controlXic/Pocket_CAN/02_CAD/01_STL/canTool.png

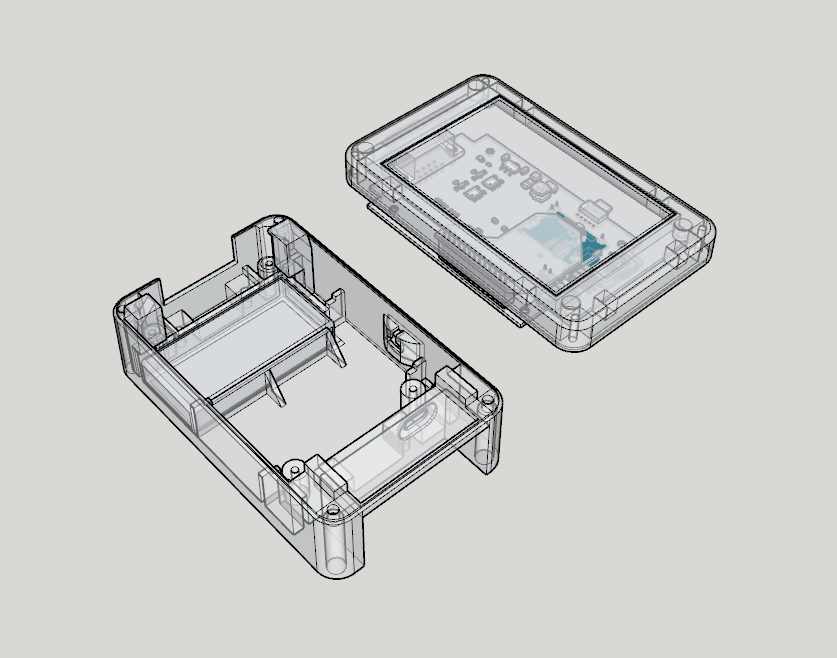
02_CAD/01_STL/canTool.png
