controlXic/Pocket_CAN/02_CAD/01_STL/_tapa.stl

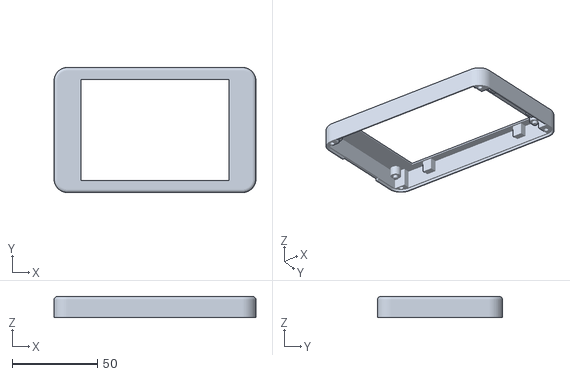
[picture p4: CAD file, 2026-11-03]
02_CAD/01_STL/_tapa.stl
118.2 x 73.3 x 12.3
