controlXic/Pocket_CAN/02_CAD/01_STL/soportsDysplay2.stl

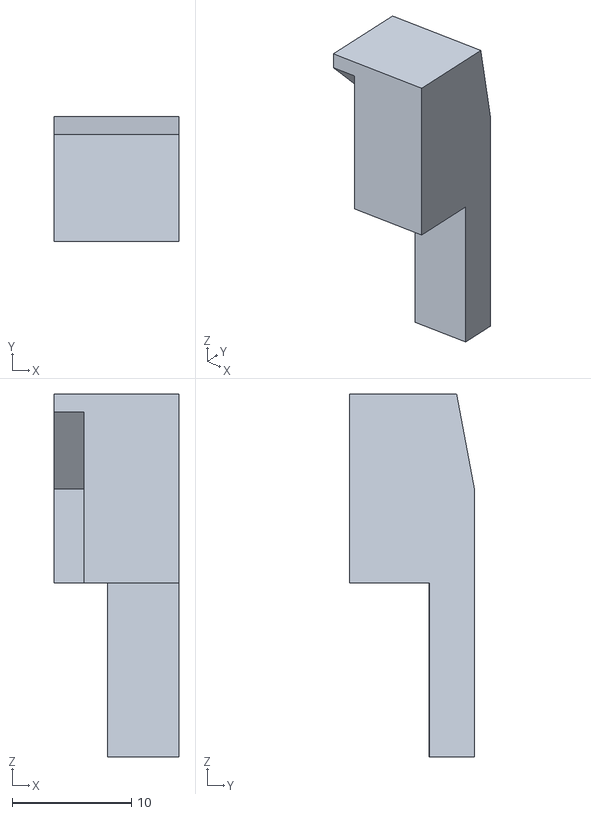
[picture p5: CAD file, 2026-11-03]
02_CAD/01_STL/soportsDysplay2.stl
10.5 x 10.5 x 30.5
