controlXic/Pocket_CAN/02_CAD/01_STL/_base.stl

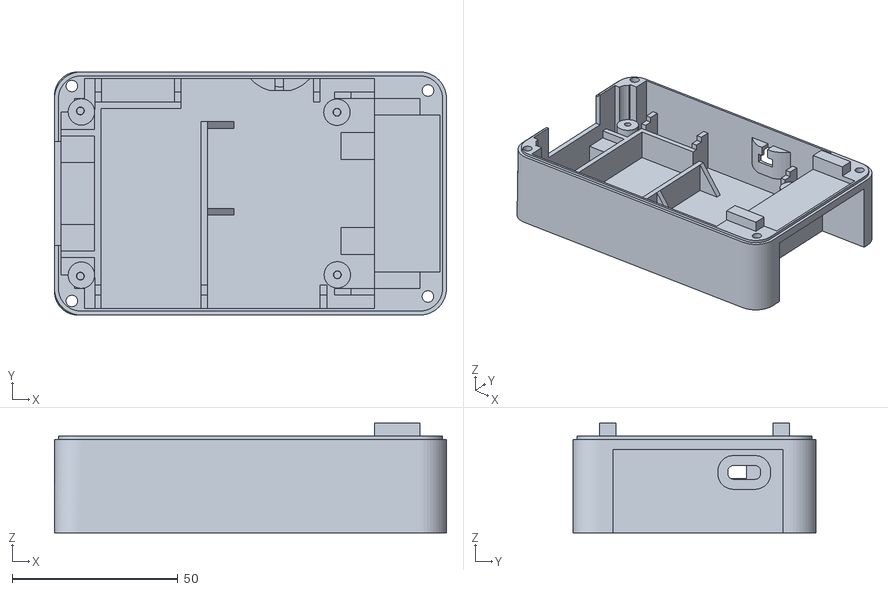
[picture p6: CAD file, 2026-11-03]
02_CAD/01_STL/_base.stl
118.2 x 73.3 x 33.1
