controlXic/Pocket_CAN/02_CAD/01_STL/base_proto_CAN_tool.stl

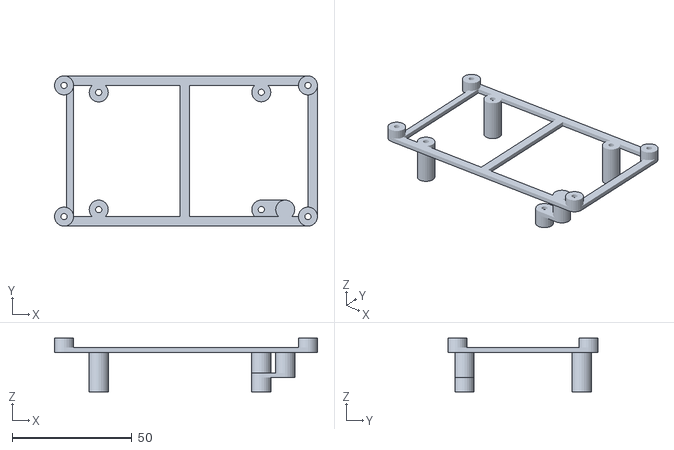
[picture p7: CAD file, 2026-11-03]
02_CAD/01_STL/base_proto_CAN_tool.stl
110.0 x 62.9 x 22.5
