controlXic/Pocket_CAN/02_CAD/01_STL/soportsDysplay.stl

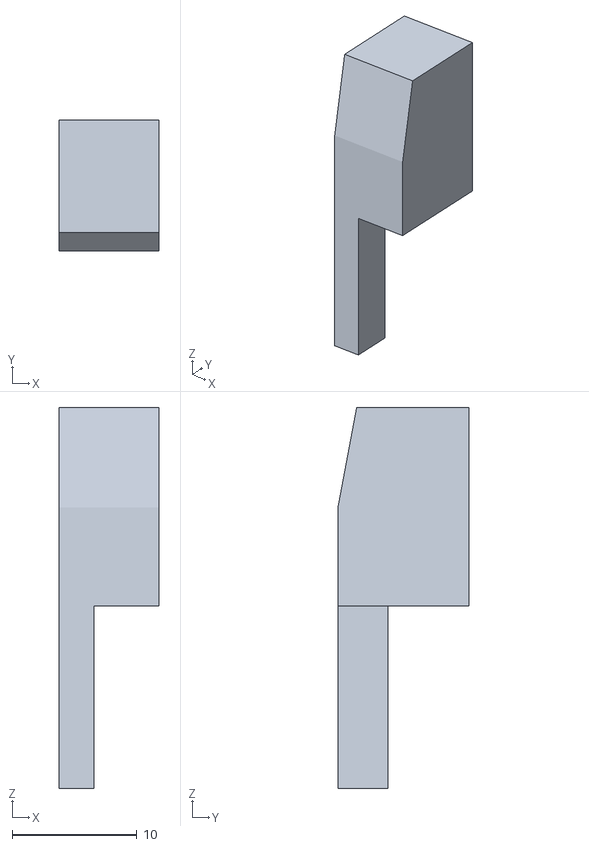
[picture p8: CAD file, 2026-11-03]
02_CAD/01_STL/soportsDysplay.stl
8.00 x 10.5 x 30.5
