controlXic/Pocket_CAN/02_CAD/01_STL/gruix_CAN_tool.stl

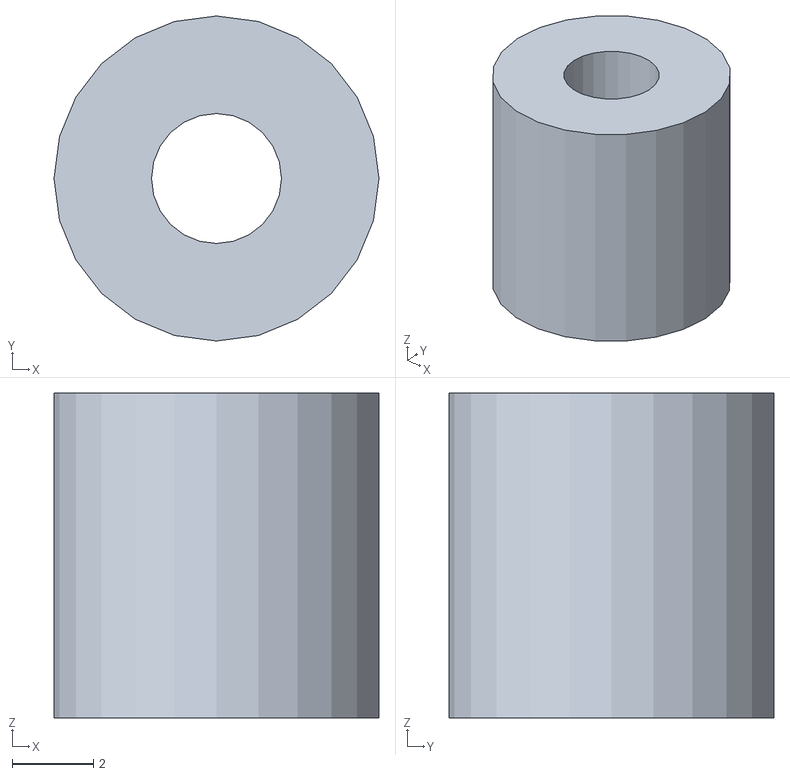
[picture p9: CAD file, 2026-11-03]
02_CAD/01_STL/gruix_CAN_tool.stl
8.00 x 8.00 x 8.00
