controlXic/Pocket_CAN/(list of files, cad)

Other CAD files:
02_CAD/00_WORK/CAN_tool.skp
