controlXic/Pocket_CAN/01_PCB/PCB_STM32G474/PCB_STM32G474.kicad_pcb

## KiCad design 01_PCB/PCB_STM32G474/PCB_STM32G474.kicad_pcb (2026-11-03)

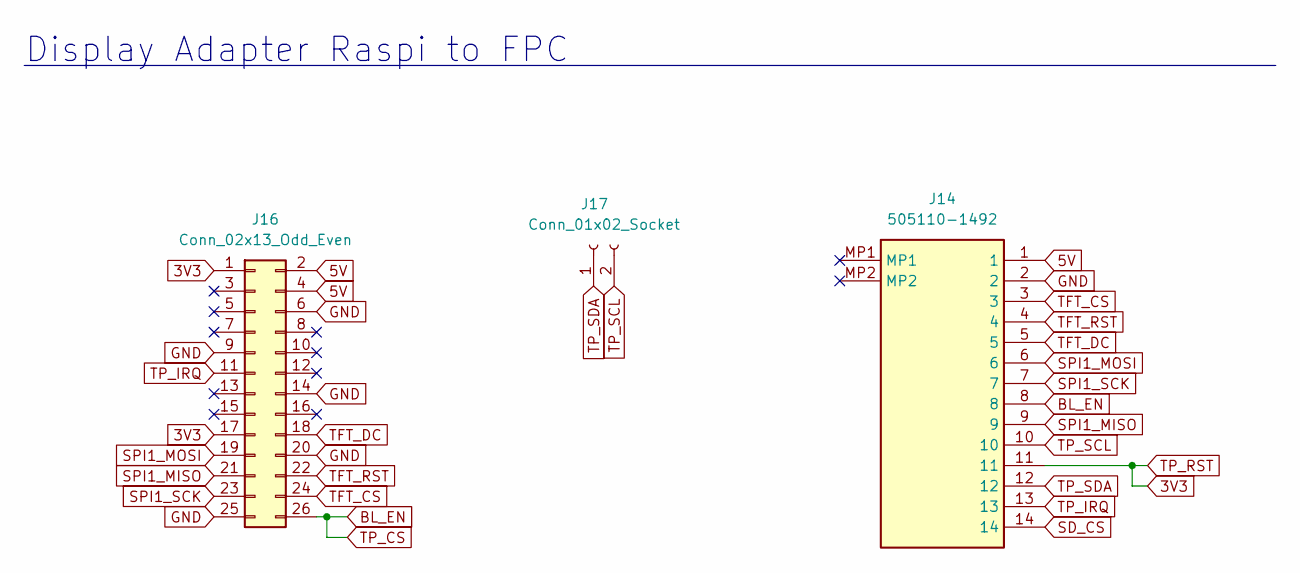
[picture p10: schematic displayadapter.kicad_sch]

Parts:
J14: 505110-1492; 5051101492; Manufacturer_Part_Number 505110-1492; Mouser Part Number 538-505110-1492
J16: Conn_02x13_Odd_Even; PinSocket_2x13_P2.54mm_Vertical
J17: Conn_01x02_Socket; PinSocket_1x02_P2.54mm_Vertical

Connections:
3V3: J14.11, J16.1, J16.17; also elsewhere on the board
5V: J14.1, J16.2, J16.4; also elsewhere on the board
BL_EN: J14.8, J16.26; also elsewhere on the board
GND: J14.2, J16.6, J16.9, J16.14, J16.20, J16.25; also elsewhere on the board
IO1: J14.12, J17.1; also elsewhere on the board
IO2: J14.10, J17.2; also elsewhere on the board
SD_CS: J14.14; also elsewhere on the board
SPI1_MISO: J14.9, J16.21; also elsewhere on the board
SPI1_MOSI: J14.6, J16.19; also elsewhere on the board
SPI1_SCK: J14.7, J16.23; also elsewhere on the board
TFT_CS: J14.3, J16.24; also elsewhere on the board
TFT_DC: J14.5, J16.18; also elsewhere on the board
TFT_RST: J14.4, J16.22; also elsewhere on the board
TP_IRQ: J14.13, J16.11; also elsewhere on the board

Notes on the sheet:
Display Adapter Raspi to FPC

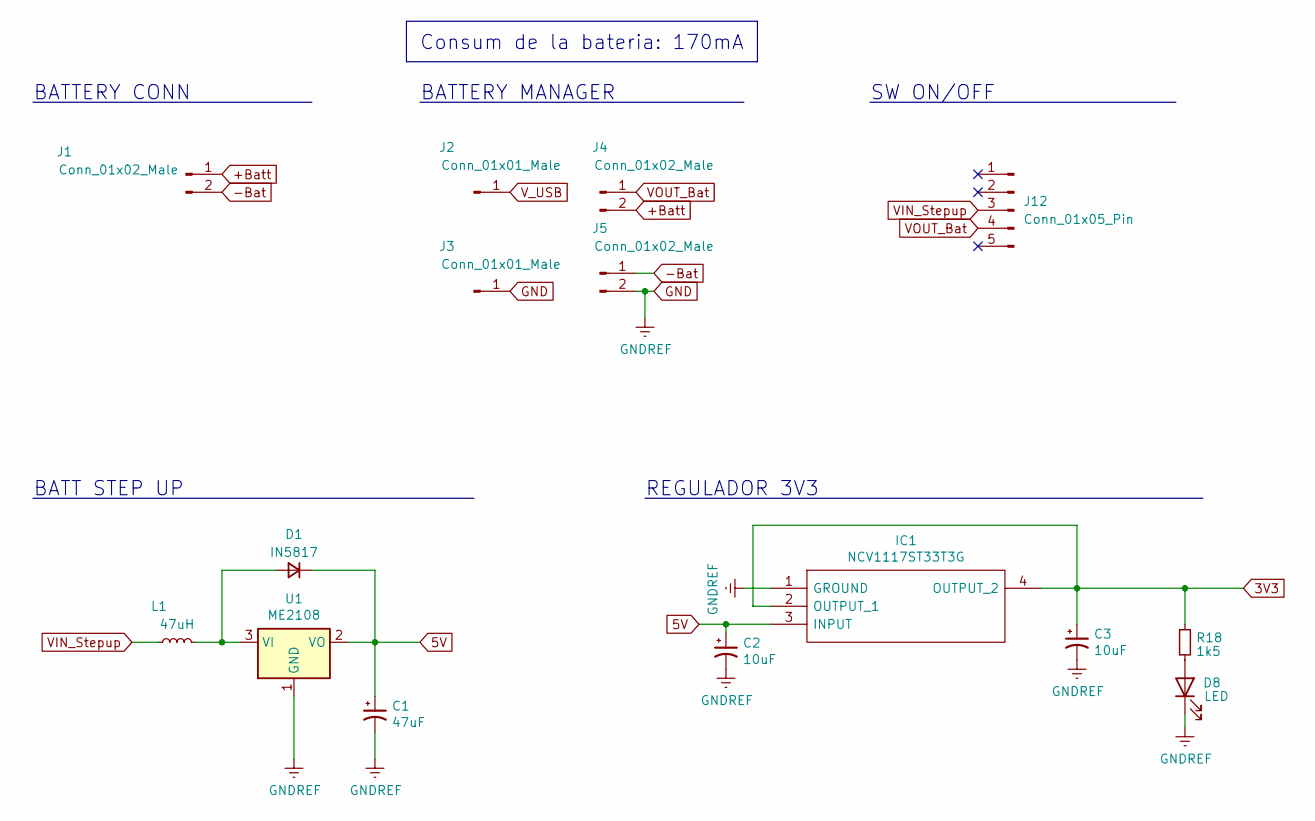
[picture p11: schematic pwr.kicad_sch]

Parts:
C1: 47uF; CP_EIA-3528-21_Kemet-B_Pad1.50x2.35mm_HandSolder
C2, C3: 10uF; CP_EIA-3216-18_Kemet-A
D1: IN5817; D_SMA
D8: LED; LED_1206_3216Metric
IC1: NCV1117ST33T3G; SOT-223-3_TabPin2; Manufacturer_Part_Number NCV1117ST33T3G; Mouser Part Number 863-NCV1117ST33T3G
J1: Conn_01x02_Male; PinHeader_1x02_P2.54mm_Horizontal
J2, J3: Conn_01x01_Male; PinSocket_1x01_P2.54mm_Vertical
J4, J5: Conn_01x02_Male; PinSocket_1x02_P2.54mm_Vertical
J12: Conn_01x05_Pin; PinHeader_1x05_P2.00mm_Vertical
L1: 47uH; L_Bourns_SRN6045TA
R18: 1k5; R_0805_2012Metric
U1: ME2108; SOT-89-3

Connections:
3V3: C3.1, IC1.2 (OUTPUT_1), IC1.4 (OUTPUT_2), R18.1; also elsewhere on the board
5V: C1.1, C2.1, D1.1 (K), IC1.3 (INPUT), U1.2 (VO); also elsewhere on the board
+Batt: J1.1, J4.2; also elsewhere on the board
-Bat: J1.2, J5.1
GND: C1.2, C2.2, C3.2, D8.1 (K), IC1.1 (GROUND), J3.1, J5.2, U1.1 (GND); also elsewhere on the board
unnamed: D1.2 (A), L1.2, U1.3 (VI)
unnamed: D8.2 (A), R18.2
VIN_Stepup: J12.3, L1.1
VOUT_Bat: J4.1, J12.4
V_USB: J2.1; also elsewhere on the board

Notes on the sheet:
Consum de la bateria: 170mA
REGULADOR 3V3
BATTERY CONN
BATTERY MANAGER
BATT STEP UP
SW ON/OFF

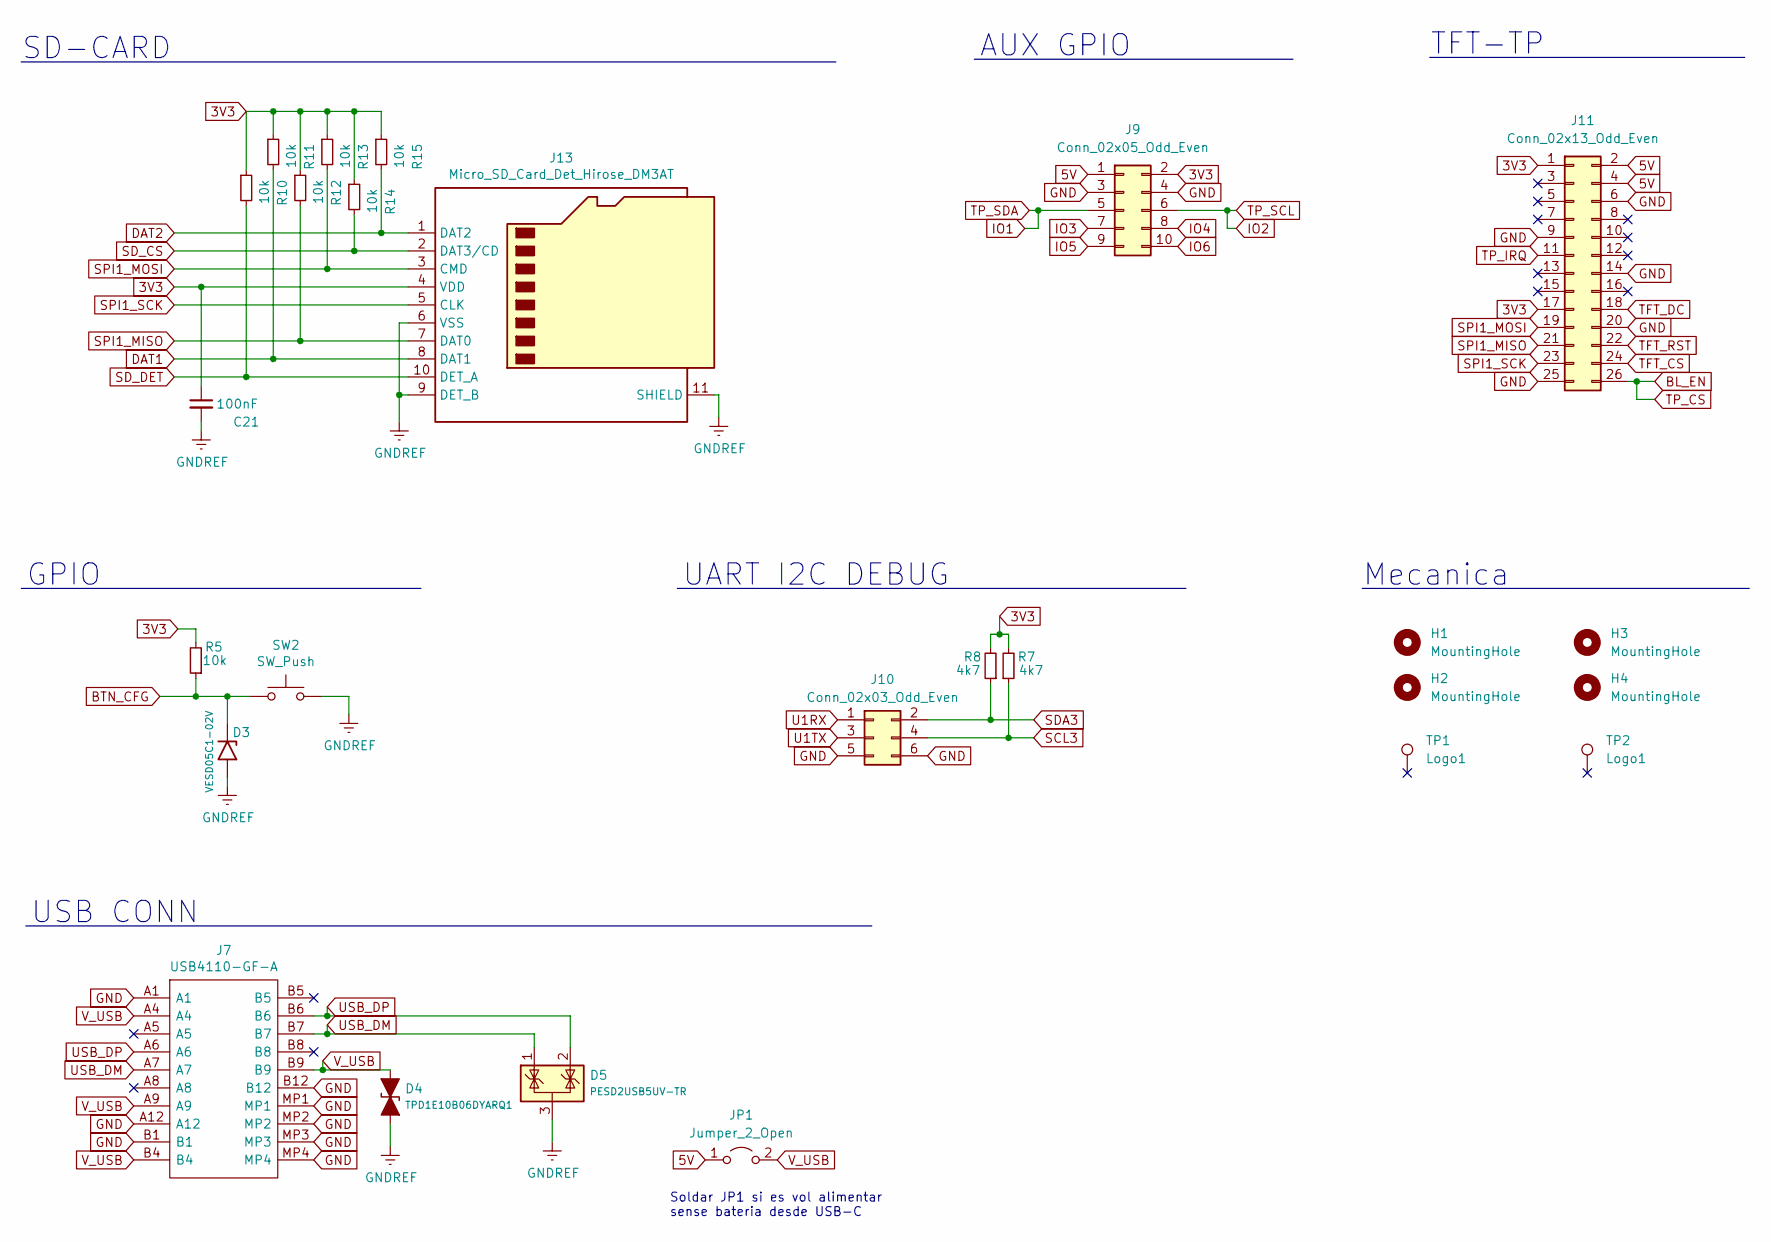
[picture p12: schematic periferics.kicad_sch]

Parts:
C21: 100nF; C_0603_1608Metric
D3: VESD05C1-02V; D_SOD-523
D4: TPD1E10B06DYARQ1; D_SOD-523
D5: PESD2USB5UV-TR; SOT-23
H1, H2, H3, H4: MountingHole; MountingHole_3.2mm_M3
J7: USB4110-GF-A; USB4110GFA; Manufacturer_Part_Number USB4110-GF-A; Mouser Part Number 640-USB4110-GF-A
J9: Conn_02x05_Odd_Even; PinHeader_2x05_P2.54mm_Horizontal
J10: Conn_02x03_Odd_Even; PinHeader_2x03_P2.54mm_Horizontal
J11: Conn_02x13_Odd_Even; PinHeader_2x13_P2.54mm_Vertical
J13: Micro_SD_Card_Det_Hirose_DM3AT; microSD_HC_Hirose_DM3AT-SF-PEJM5
JP1: Jumper_2_Open; SolderJumper-2_P1.3mm_Open_TrianglePad1.0x1.5mm
R5, R10, R11, R12, R13, R14, R15: 10k; R_0603_1608Metric
R7, R8: 4k7; R_0603_1608Metric
SW2: SW_Push; SW_SPST_CK_RS282G05A3
TP1, TP2: Logo1; cxic

Connections:
3V3: C21.1, J9.2, J11.1, J11.17, J13.4 (VDD), R5.2, R7.2, R8.2, R10.1, R11.1, R12.1, R13.1, R14.1, R15.1; also elsewhere on the board
5V: J9.1, J11.2, J11.4, JP1.1 (A); also elsewhere on the board
BL_EN: J11.26; also elsewhere on the board
BTN_CFG: D3.1 (A1), R5.1, SW2.1; also elsewhere on the board
DAT1: J13.8 (DAT1), R11.2
DAT2: J13.1 (DAT2), R15.2
GND: C21.2, D3.2 (A2), D4.2 (A2), D5.3 (A), J7.A1, J7.A12, J7.B1, J7.B12, J7.MP1, J7.MP2, J7.MP3, J7.MP4, J9.3, J9.4, J10.5, J10.6, J11.6, J11.9, J11.14, J11.20, J11.25, J13.6 (VSS), J13.9 (DET_B), J13.11 (SHIELD), SW2.2; also elsewhere on the board
IO1: J9.5; also elsewhere on the board
IO2: J9.6; also elsewhere on the board
IO3: J9.7; also elsewhere on the board
IO4: J9.8; also elsewhere on the board
IO5: J9.9; also elsewhere on the board
IO6: J9.10; also elsewhere on the board
SCL3: J10.4, R7.1; also elsewhere on the board
SDA3: J10.2, R8.1; also elsewhere on the board
SD_CS: J13.2 (DAT3/CD), R14.2; also elsewhere on the board
SD_DET: J13.10 (DET_A), R10.2; also elsewhere on the board
SPI1_MISO: J11.21, J13.7 (DAT0), R12.2; also elsewhere on the board
SPI1_MOSI: J11.19, J13.3 (CMD), R13.2; also elsewhere on the board
SPI1_SCK: J11.23, J13.5 (CLK); also elsewhere on the board
TFT_CS: J11.24; also elsewhere on the board
TFT_DC: J11.18; also elsewhere on the board
TFT_RST: J11.22; also elsewhere on the board
TP_IRQ: J11.11; also elsewhere on the board
U1RX: J10.1; also elsewhere on the board
U1TX: J10.3; also elsewhere on the board
USB_DM: D5.1 (K), J7.A7, J7.B7; also elsewhere on the board
USB_DP: D5.2 (K), J7.A6, J7.B6; also elsewhere on the board
V_USB: D4.1 (A1), J7.A4, J7.A9, J7.B4, J7.B9, JP1.2 (B); also elsewhere on the board

Notes on the sheet:
Soldar JP1 si es vol alimentar sense bateria desde USB-C
SD-CARD
UART I2C DEBUG
TFT-TP
AUX GPIO
USB CONN
Mecanica
GPIO

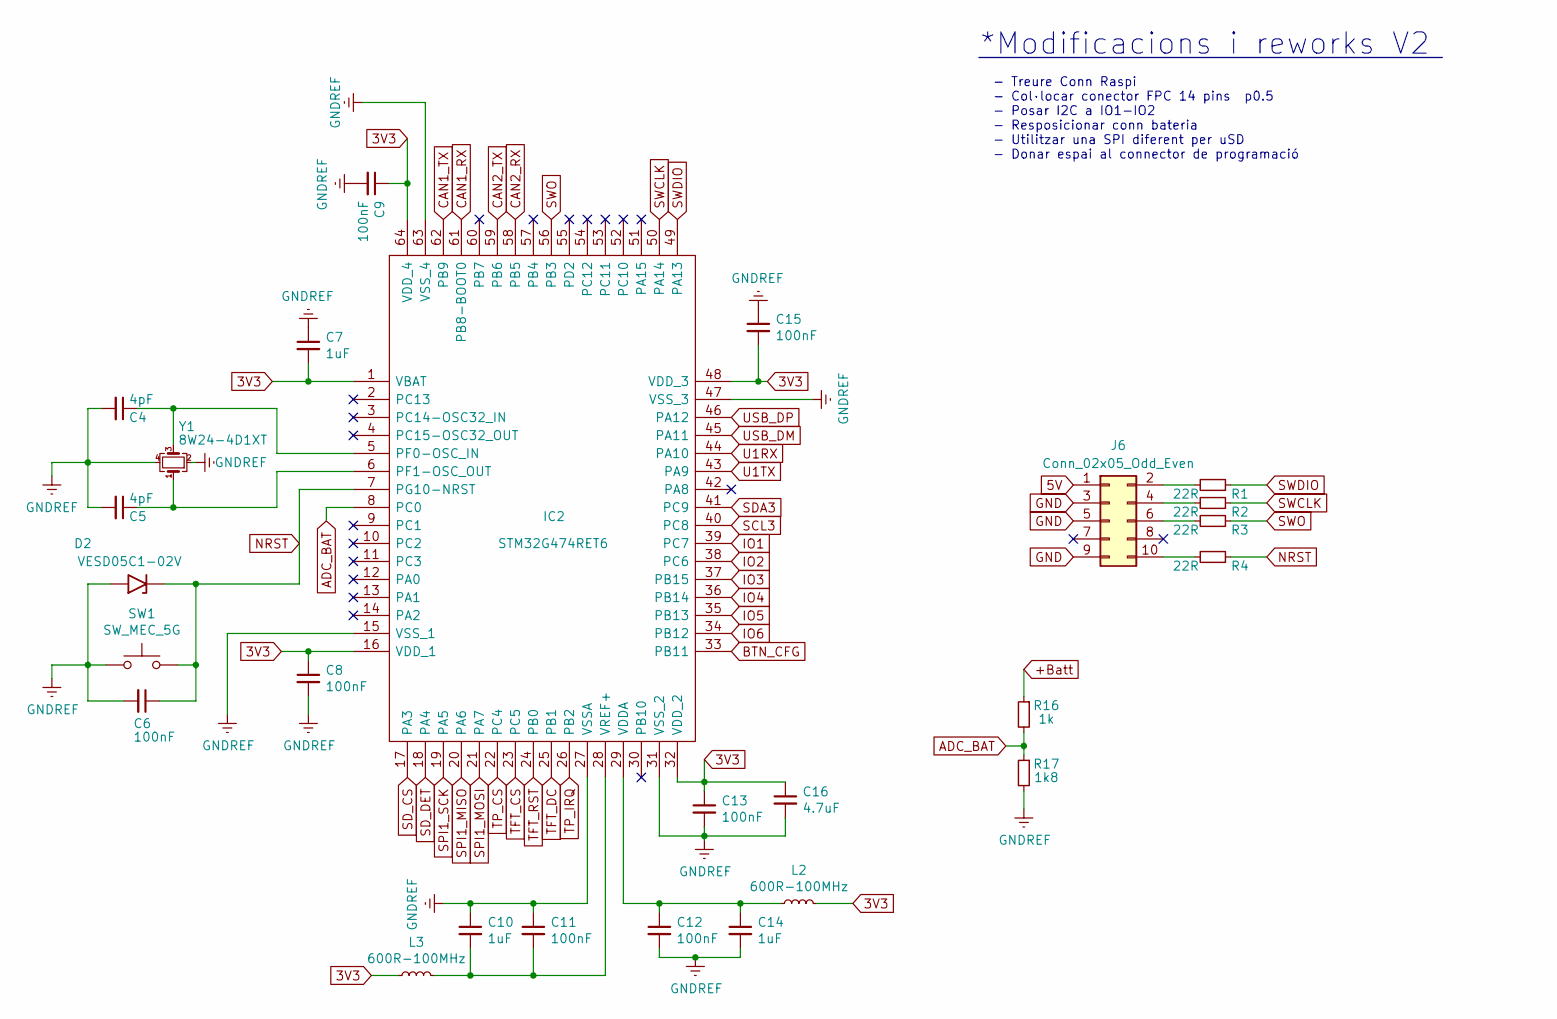
[picture p13: schematic mcu.kicad_sch]

Parts:
C4, C5: 4pF; C_0805_2012Metric
C6, C8, C9, C11, C12, C13, C15: 100nF; C_0603_1608Metric
C7, C10, C14: 1uF; C_0805_2012Metric
C16: 4.7uF; C_0805_2012Metric
D2: VESD05C1-02V; D_SOD-523
IC2: STM32G474RET6; QFP50P1200X1200X160-64N; Manufacturer_Part_Number STM32G474RET6; Mouser Part Number 511-STM32G474RET6
J6: Conn_02x05_Odd_Even; PinHeader_2x05_P1.27mm_Vertical
L2, L3: 600R-100MHz; C_0805_2012Metric
R1, R2, R3, R4: 22R; R_0603_1608Metric
R16: 1k; R_0603_1608Metric
R17: 1k8; R_0603_1608Metric
SW1: SW_MEC_5G; 223JMVAAR
Y1: 8W24-4D1XT; ABM8W480000MHZ6D1XT3

Connections:
3V3: C7.2, C8.1, C9.1, C13.1, C15.2, C16.1, IC2.1 (VBAT), IC2.16 (VDD_1), IC2.32 (VDD_2), IC2.48 (VDD_3), IC2.64 (VDD_4), L2.2, L3.1; also elsewhere on the board
5V: J6.1; also elsewhere on the board
+Batt: R16.1; also elsewhere on the board
ADC_BAT: IC2.8 (PC0), R16.2, R17.1
BL_EN: IC2.22 (PC4); also elsewhere on the board
BTN_CFG: IC2.33 (PB11); also elsewhere on the board
CAN1_RX: IC2.61 (PB8-BOOT0); also elsewhere on the board
CAN1_TX: IC2.62 (PB9); also elsewhere on the board
CAN2_RX: IC2.58 (PB5); also elsewhere on the board
CAN2_TX: IC2.59 (PB6); also elsewhere on the board
GND: C4.2, C5.2, C6.2, C7.1, C8.2, C9.2, C10.1, C11.1, C12.2, C13.2, C14.2, C15.1, C16.2, D2.2 (A2), IC2.15 (VSS_1), IC2.27 (VSSA), IC2.31 (VSS_2), IC2.47 (VSS_3), IC2.63 (VSS_4), J6.3, J6.5, J6.9, R17.2, SW1.2, Y1.2, Y1.4; also elsewhere on the board
IO1: IC2.39 (PC7); also elsewhere on the board
IO2: IC2.38 (PC6); also elsewhere on the board
IO3: IC2.37 (PB15); also elsewhere on the board
IO4: IC2.36 (PB14); also elsewhere on the board
IO5: IC2.35 (PB13); also elsewhere on the board
IO6: IC2.34 (PB12); also elsewhere on the board
NRST: C6.1, D2.1 (A1), IC2.7 (PG10-NRST), R4.1, SW1.1
unnamed: C4.1, IC2.5 (PF0-OSC_IN), Y1.3
unnamed: C5.1, IC2.6 (PF1-OSC_OUT), Y1.1
unnamed: C12.1, C14.1, IC2.29 (VDDA), L2.1
unnamed: C10.2, C11.2, IC2.28 (VREF+), L3.2
unnamed: J6.2, R1.2
unnamed: J6.4, R2.2
unnamed: J6.6, R3.2
unnamed: J6.10, R4.2
SCL3: IC2.40 (PC8); also elsewhere on the board
SDA3: IC2.41 (PC9); also elsewhere on the board
SD_CS: IC2.17 (PA3); also elsewhere on the board
SD_DET: IC2.18 (PA4); also elsewhere on the board
SPI1_MISO: IC2.20 (PA6); also elsewhere on the board
SPI1_MOSI: IC2.21 (PA7); also elsewhere on the board
SPI1_SCK: IC2.19 (PA5); also elsewhere on the board
SWCLK: IC2.50 (PA14), R2.1
SWDIO: IC2.49 (PA13), R1.1
SWO: IC2.56 (PB3), R3.1
TFT_CS: IC2.23 (PC5); also elsewhere on the board
TFT_DC: IC2.25 (PB1); also elsewhere on the board
TFT_RST: IC2.24 (PB0); also elsewhere on the board
TP_IRQ: IC2.26 (PB2); also elsewhere on the board
U1RX: IC2.44 (PA10); also elsewhere on the board
U1TX: IC2.43 (PA9); also elsewhere on the board
USB_DM: IC2.45 (PA11); also elsewhere on the board
USB_DP: IC2.46 (PA12); also elsewhere on the board

Notes on the sheet:
*Modificacions i reworks V2
- Treure Conn Raspi - Col·locar conector FPC 14 pins p0.5 - Posar I2C a IO1-IO2 - Resposicionar conn bateria - Utilitzar una SPI diferent per uSD - Donar espai al connector de programació

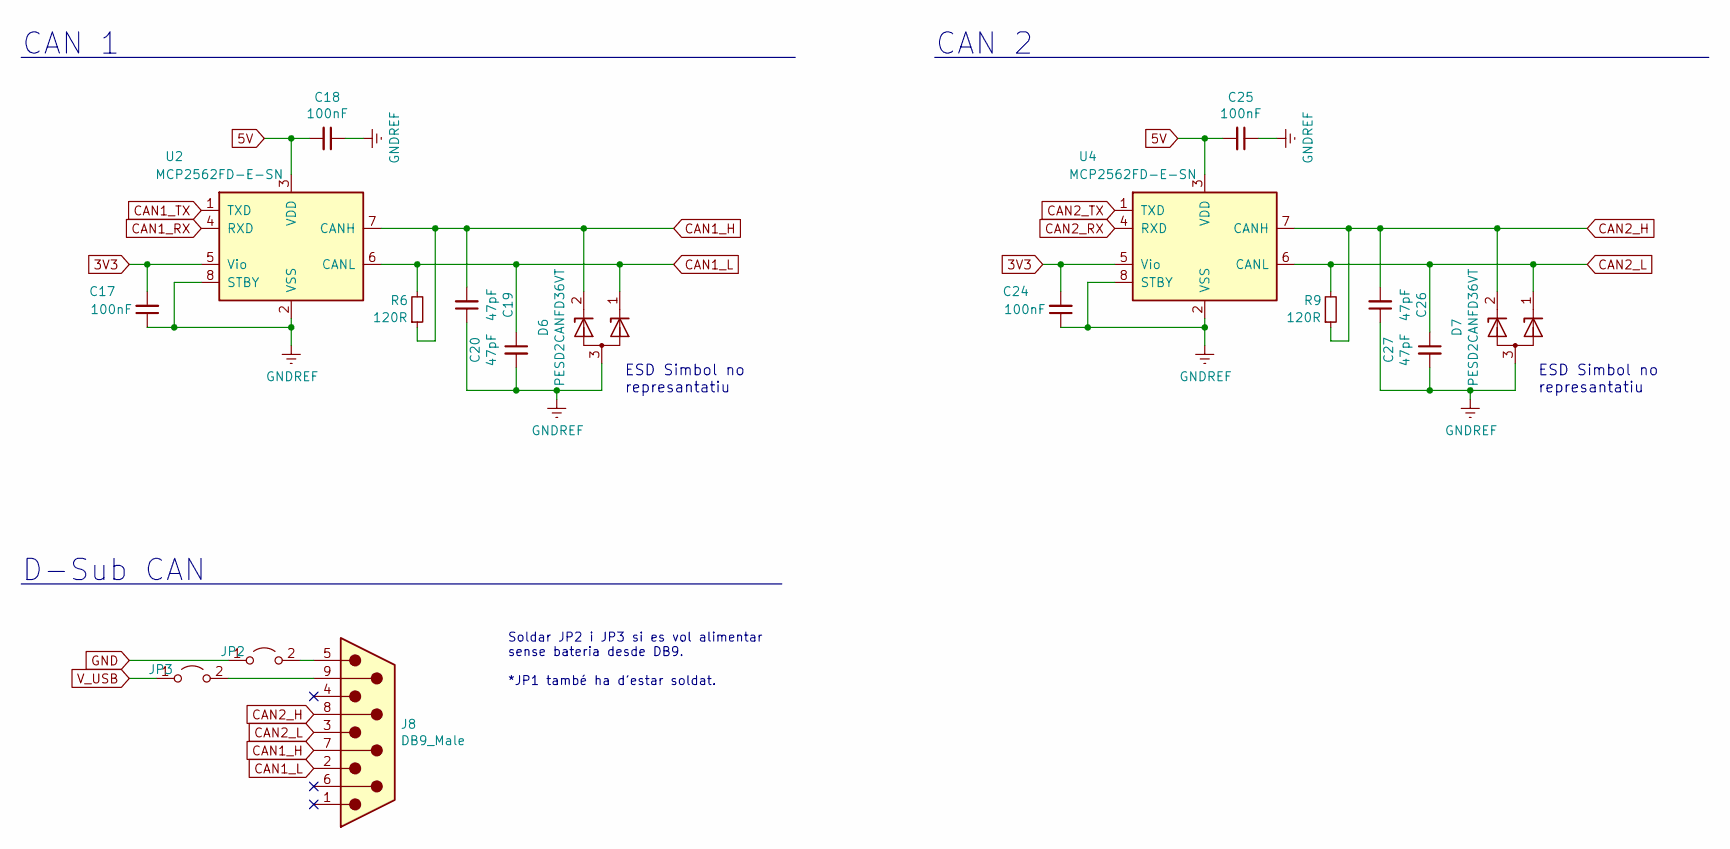
[picture p14: schematic can.kicad_sch]

Parts:
C17, C18, C24, C25: 100nF; C_0603_1608Metric
C19, C20, C26, C27: 47pF; C_0603_1608Metric
D6, D7: PESD2CANFD36VT; SOT-23
J8: DB9_Male; DSUB-9_Male_Horizontal_P2.77x2.84mm_EdgePinOffset7.70mm_Hou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
JP2, JP3: Jumper_2_Open; SolderJumper-2_P1.3mm_Open_TrianglePad1.0x1.5mm
R6, R9: 120R; R_0805_2012Metric
U2, U4: MCP2562FD-E-SN; SOIC-8_3.9x4.9mm_P1.27mm

Connections:
3V3: C17.2, C24.2, U2.5 (Vio), U4.5 (Vio); also elsewhere on the board
5V: C18.2, C25.2, U2.3 (VDD), U4.3 (VDD); also elsewhere on the board
CAN1_H: C19.2, D6.2 (K), J8.7, R6.1, U2.7 (CANH)
CAN1_L: C20.1, D6.1 (K), J8.2, R6.2, U2.6 (CANL)
CAN1_RX: U2.4 (RXD); also elsewhere on the board
CAN1_TX: U2.1 (TXD); also elsewhere on the board
CAN2_H: C26.2, D7.2 (K), J8.8, R9.1, U4.7 (CANH)
CAN2_L: C27.1, D7.1 (K), J8.3, R9.2, U4.6 (CANL)
CAN2_RX: U4.4 (RXD); also elsewhere on the board
CAN2_TX: U4.1 (TXD); also elsewhere on the board
GND: C17.1, C18.1, C19.1, C20.2, C24.1, C25.1, C26.1, C27.2, D6.3 (A), D7.3 (A), JP2.1 (A), U2.2 (VSS), U2.8 (STBY), U4.2 (VSS), U4.8 (STBY); also elsewhere on the board
unnamed: J8.5, JP2.2 (B)
unnamed: J8.9, JP3.2 (B)
V_USB: JP3.1 (A); also elsewhere on the board

Notes on the sheet:
ESD Simbol no represantatiu
Soldar JP2 i JP3 si es vol alimentar sense bateria desde DB9. *JP1 també ha d'estar soldat.
CAN 1
D-Sub CAN
CAN 2

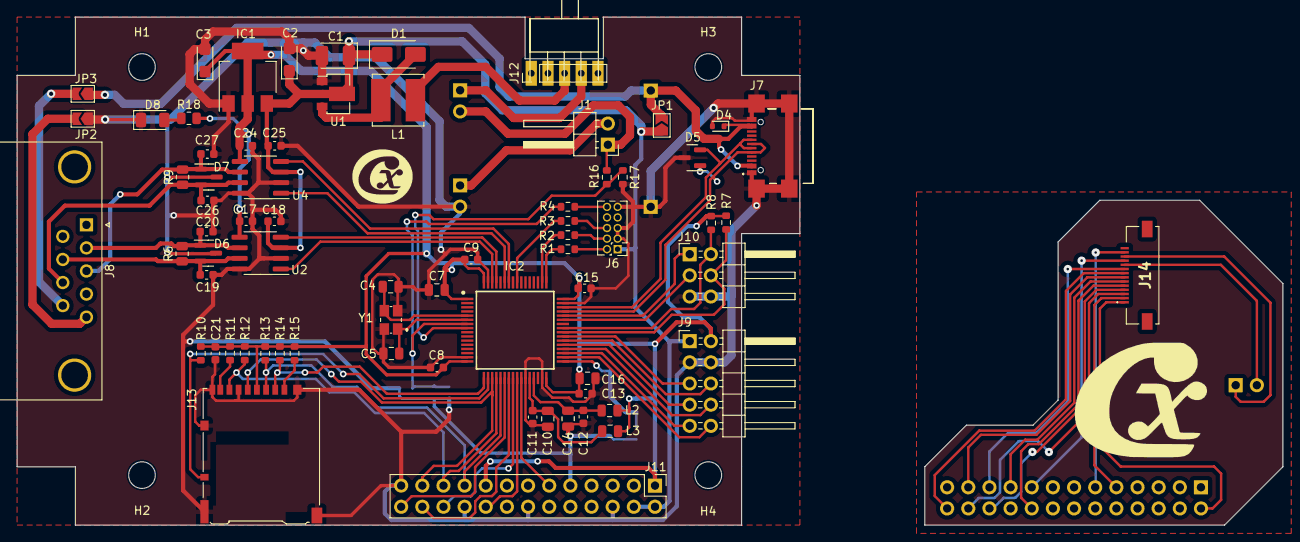
[picture p15: board PCB_STM32G474.kicad_pcb from above]

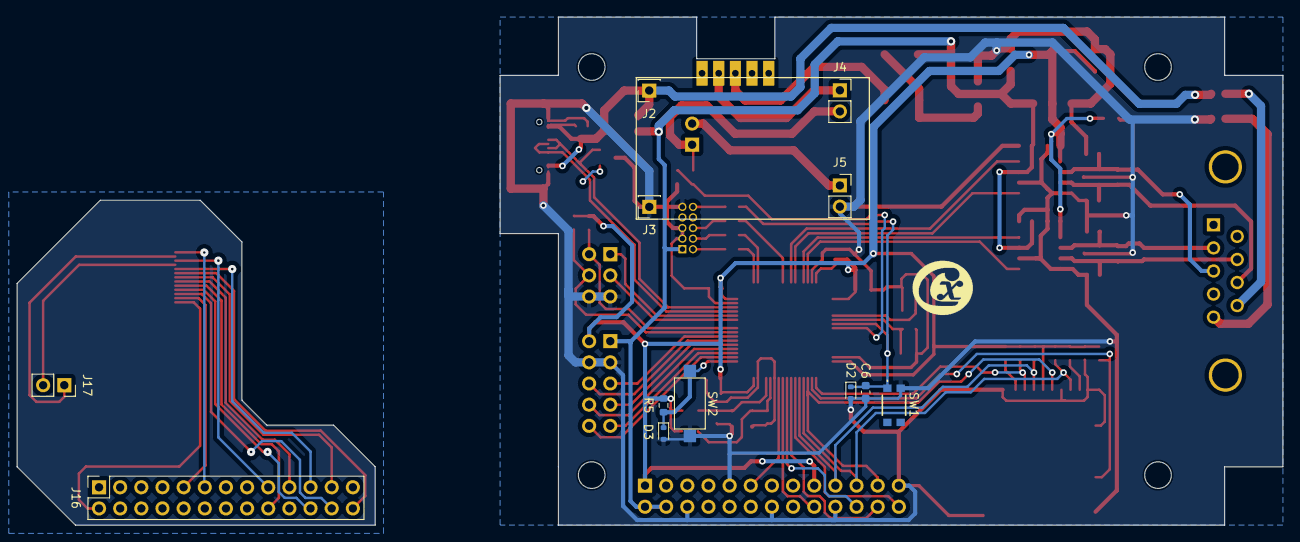
[picture p16: board PCB_STM32G474.kicad_pcb from below]

Board: 2 copper layers, 94.0 x 61.0 mm, 88 parts (13 on the bottom side), 58 nets.

Other parts of the board:
 : LOGO
