controlXic/Pocket_CAN/00_FIRMWARE/STM32G474ws/canfd_tool_g474ret6/Core/Src/main.c

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
/* Includes ------------------------------------------------------------------*/
#include "main.h"
#include "usb_device.h"

/* USER CODE BEGIN Includes */
//#include "ili9486.h"
#include "stdio.h"
#include "usbd_cdc_if.h"
#include "st7796s.h"
#include "lvgl.h"
#include "main_system.h"
#include "main_window.h"
#include "can_rx.h"
#include "stm32g4xx_hal_fdcan.h"
/* USER CODE END Includes */

ADC_HandleTypeDef hadc1;

FDCAN_HandleTypeDef hfdcan1;

I2C_HandleTypeDef hi2c4;
DMA_HandleTypeDef hdma_i2c4_rx;
DMA_HandleTypeDef hdma_i2c4_tx;

SPI_HandleTypeDef hspi1;
DMA_HandleTypeDef hdma_spi1_tx;

UART_HandleTypeDef huart1;

/* USER CODE BEGIN PV */


// Time vars //
extern uint32_t millis;
extern uint32_t rxTimeoutMillis;

extern uint32_t sleepMillis;

// Confgi vars //
extern bool staticMode;
bool msgRxSleepFlg = false;

// CDC vars //
uint32_t cdcRxData[30][80];
uint8_t strCdc[100];

// USART vars //
uint8_t usartLines = 30;
uint8_t rowCnt = 1;
uint32_t rowCntOld = 0;
uint32_t rowCntFull = 1;

// Touch vars //
bool touchFlg = false;

// CAN vars //
FDCAN_TxHeaderTypeDef TxHeader1;
FDCAN_RxHeaderTypeDef RxHeader1;
FDCAN_ProtocolStatusTypeDef fdcanStatus;
uint8_t can1RxData1[8];
uint32_t rxFramesCnt = 0;
bool rxCanFlg = false;
bool rxTimeoutFlg = false;

// Busload time vars //
#define STD_FIXED_BITS 55 // Reals = 47 b/f (dlc = 0)
float oneSeconBitsCan1 = 0;
uint16_t frameBitsCan1 = 0;
uint8_t busLoadBitRate = 20;

// Flow vars //
bool initFlg = true;
extern bool touchSleepFlg;

// LVGL vars //
extern lv_obj_t * tabview;
extern lv_obj_t * uartRxTable;

// test vars //
uint32_t errorCode = 0;
bool errorFlag = false;



/* USER CODE END PV */

void SystemClock_Config(void);
static void MX_GPIO_Init(void);
static void MX_DMA_Init(void);
static void MX_SPI1_Init(void);
static void MX_USART1_UART_Init(void);
static void MX_ADC1_Init(void);
static void MX_FDCAN1_Init(void);
static void MX_I2C4_Init(void);
/* USER CODE BEGIN PFP */

//extern uint8_t CDC_Transmit_FS(uint8_t*, uint16_t);
//extern int8_t CDC_Receive_FS_Global(uint8_t*, uint32_t);

/* USER CODE END PFP */

/* USER CODE BEGIN 0 */



//////////////////////////////////////////////////////////////////////////
// CDC write-read
//////////////////////////////////////////////////////////////////////////

void usb_print(char mytext[])
{
	CDC_Transmit_FS((uint8_t*)mytext,strlen(mytext));
	//HAL_Delay(10);
}

void USB_CDC_RxHandler(uint8_t* cdcBuf, uint32_t len)
{

	if(lv_tabview_get_tab_active(tabview) == 2)
	{
		if(cdcBuf[0] != 0)
		{
			if(rowCnt >= usartLines)
				rowCnt = 1;

//			memcpy(cdcRxData[rowCnt], "", 80);
//			memcpy(cdcRxData[rowCnt], buf, 80);

			memset(cdcRxData[rowCnt], '\0', 80);
			strcat(cdcRxData[rowCnt], "RX:  ");
			strcat(cdcRxData[rowCnt], cdcBuf);

			cdcRxData[rowCnt][78] = rowCnt;
			cdcRxData[rowCnt][79] = rowCntFull;

			rowCnt++;
			rowCntFull++;
			msgRxSleepFlg = true;
		}
	}
	else
	{
		// Apply read cmd //
		switch(cdcBuf[0])
		{
			case '0':
				usb_print("\r\ncontrolXic");
			break;

			case '1':

			break;

			case '2':

			break;

			case '3':

			break;

			case '4':

			break;
		}
	}
	memset(cdcBuf, '\0', 80);
}


//////////////////////////////////////////////////////////////////////////
// LvGL LOG
//////////////////////////////////////////////////////////////////////////

void my_log_cb(lv_log_level_t level, const char * buf)
{
	CDC_Transmit_FS(buf, strlen(buf));
	HAL_Delay(10);
}


//////////////////////////////////////////////////////////////////////////
// CAN Read - Write Interrupts
//////////////////////////////////////////////////////////////////////////


void HAL_FDCAN_ErrorStatusCallback(FDCAN_HandleTypeDef *hfdcan, uint32_t ErrorStatusITs)
{

	if(ErrorStatusITs & FDCAN_IT_ERROR_WARNING)
	{
		error_msgbox("FDCAN_IT_ERROR_WARNING");
	}

	if(ErrorStatusITs & FDCAN_IT_ERROR_PASSIVE)
	{
		error_msgbox("FDCAN_IT_ERROR_PASSIVE");
	}

	if(ErrorStatusITs & FDCAN_IT_BUS_OFF)
	{
//		sprintf(strCdc, "\n\r FDCAN_IT_BUS_OFF ERROR: %X ", ErrorStatusITs);
//		usb_print(strCdc);
	}
}


void HAL_FDCAN_TxEventFifoCallback(FDCAN_HandleTypeDef *hfdcan, uint32_t TxEventFifoITs)
{
//	usb_print("\n\rFDCAN_IT_TX_EVT_FIFO_NEW_DATA");

//	if((TxEventFifoITs & FDCAN_IT_TX_EVT_FIFO_NEW_DATA) != RESET)
//	{
//		usb_print("\n\rFDCAN_IT_TX_EVT_FIFO_NEW_DATA");
//		HAL_FDCAN_ActivateNotification(&hfdcan1, FDCAN_IT_TX_EVT_FIFO_NEW_DATA, 0);
//	}
}

void HAL_FDCAN_TxFifoEmptyCallback(FDCAN_HandleTypeDef *hfdcan)
{
	usb_print("\n\rFDCAN_IT_TX_FIFO_EMPTY");
}


//////////////////////////////////////////////////////////////////////////
// CAN Read Callback
//////////////////////////////////////////////////////////////////////////

void HAL_FDCAN_RxFifo0Callback(FDCAN_HandleTypeDef *hfdcan, uint32_t RxFifo0ITs)
{
	if((RxFifo0ITs & FDCAN_IT_RX_FIFO0_NEW_MESSAGE) != RESET)
	{
	    if (HAL_FDCAN_GetRxMessage(hfdcan, FDCAN_RX_FIFO0, &RxHeader1, can1RxData1) != HAL_OK)
	    {
	    	Error_Handler();
	    }
		if (HAL_FDCAN_ActivateNotification(hfdcan, FDCAN_IT_RX_FIFO0_NEW_MESSAGE, 0) != HAL_OK)
	    {
			Error_Handler();
	    }
		// count frames //
		rxFramesCnt++;

        // Busload bit count //
        frameBitsCan1 = STD_FIXED_BITS + (RxHeader1.DataLength * 8);
        oneSeconBitsCan1 = oneSeconBitsCan1 + frameBitsCan1;


		// save on can rx buffer //
		if((initFlg == false) /*&& (lv_tabview_get_tab_active(tabview) == 0)*/)
		{
			rxCanFlg = true;
			msgRxSleepFlg = true;
			rxTimeoutFlg = true;
			rxTimeoutMillis = millis;


			  if(staticMode)
				  save_rx_buf_static(RxHeader1.Identifier, RxHeader1.DataLength, can1RxData1);
			  else
				  save_rx_buf_dinamic(RxHeader1.Identifier, RxHeader1.DataLength, can1RxData1);
		}
	}
}


//////////////////////////////////////////////////////////////////////////
// CAN bit rate config (kbit/s)
//////////////////////////////////////////////////////////////////////////

void FDCAN1_bit_rate_config(uint8_t bitRate)
{
	busLoadBitRate = bitRate;

	hfdcan1.Instance = FDCAN1;
	hfdcan1.Init.ClockDivider = FDCAN_CLOCK_DIV1;
	hfdcan1.Init.FrameFormat = FDCAN_FRAME_CLASSIC;
	hfdcan1.Init.Mode = FDCAN_MODE_NORMAL;
	hfdcan1.Init.AutoRetransmission = DISABLE;
	hfdcan1.Init.TransmitPause = DISABLE;
	hfdcan1.Init.ProtocolException = DISABLE;
	hfdcan1.Init.NominalPrescaler = bitRate;
	hfdcan1.Init.NominalSyncJumpWidth = 16;
	hfdcan1.Init.NominalTimeSeg1 = 13;
	hfdcan1.Init.NominalTimeSeg2 = 2;
	hfdcan1.Init.DataPrescaler = 1;
	hfdcan1.Init.DataSyncJumpWidth = 1;
	hfdcan1.Init.DataTimeSeg1 = 1;
	hfdcan1.Init.DataTimeSeg2 = 1;
	hfdcan1.Init.StdFiltersNbr = 2;
	hfdcan1.Init.ExtFiltersNbr = 2;
	hfdcan1.Init.TxFifoQueueMode = FDCAN_TX_FIFO_OPERATION;

	if (HAL_FDCAN_Init(&hfdcan1) != HAL_OK)
	{
		Error_Handler();
	}
}


//////////////////////////////////////////////////////////////////////////
// CAN Filters config
//////////////////////////////////////////////////////////////////////////

void FDCAN_config_filters(uint32_t F1, uint32_t F2, uint32_t F3, uint32_t F4)
{
	// Apagar CAN bus //
	if (HAL_FDCAN_Stop(&hfdcan1) != HAL_OK)
	{
	  Error_Handler();
	}

	// Si un Filtre es configurat habilita filtres //
	if(F1 > 0x00 || F2 > 0x00 || F3 > 0x00 || F4 > 0x00)
	{
		// Configure Rx filter //
		FDCAN_FilterTypeDef sFilterConfig;


		sFilterConfig.IdType = FDCAN_STANDARD_ID;
		sFilterConfig.FilterIndex = 0;
		sFilterConfig.FilterType = FDCAN_FILTER_DUAL;
		sFilterConfig.FilterConfig = FDCAN_FILTER_TO_RXFIFO0;

		if(F1 <= 0x7FF)
			sFilterConfig.FilterID1 = F1;
		else
			sFilterConfig.FilterID1 = 0x00;

		if(F2 <= 0x7FF)
			sFilterConfig.FilterID2 = F2;
		else
			sFilterConfig.FilterID2 = 0x00;

		if(HAL_FDCAN_ConfigFilter(&hfdcan1, &sFilterConfig) != HAL_OK)
		{
			  Error_Handler();
		}

		sFilterConfig.IdType = FDCAN_STANDARD_ID;
		sFilterConfig.FilterIndex = 1;
		sFilterConfig.FilterType = FDCAN_FILTER_DUAL;
		sFilterConfig.FilterConfig = FDCAN_FILTER_TO_RXFIFO0;

		if(F3 <= 0x7FF)
			sFilterConfig.FilterID1 = F3;
		else
			sFilterConfig.FilterID1 = 0x00;

		if(F4 <= 0x7FF)
			sFilterConfig.FilterID2 = F4;
		else
			sFilterConfig.FilterID2 = 0x00;

		if(HAL_FDCAN_ConfigFilter(&hfdcan1, &sFilterConfig) != HAL_OK)
		{
			  Error_Handler();
		}

		sFilterConfig.IdType = FDCAN_EXTENDED_ID;
		sFilterConfig.FilterIndex = 0;
		sFilterConfig.FilterType = FDCAN_FILTER_DUAL;
		sFilterConfig.FilterConfig = FDCAN_FILTER_TO_RXFIFO0;

		if(F1 > 0x7FF)
			sFilterConfig.FilterID1 = F1;
		else
			sFilterConfig.FilterID1 = 0x00;

		if(F2 > 0x7FF)
			sFilterConfig.FilterID2 = F2;
		else
			sFilterConfig.FilterID2 = 0x00;

		if(HAL_FDCAN_ConfigFilter(&hfdcan1, &sFilterConfig) != HAL_OK)
		{
			  Error_Handler();
		}

		sFilterConfig.IdType = FDCAN_EXTENDED_ID;
		sFilterConfig.FilterIndex = 1;
		sFilterConfig.FilterType = FDCAN_FILTER_DUAL;
		sFilterConfig.FilterConfig = FDCAN_FILTER_TO_RXFIFO0;

		if(F3 > 0x7FF)
			sFilterConfig.FilterID1 = F3;
		else
			sFilterConfig.FilterID1 = 0x00;

		if(F4 > 0x7FF)
			sFilterConfig.FilterID2 = F4;
		else
			sFilterConfig.FilterID2 = 0x00;

		if(HAL_FDCAN_ConfigFilter(&hfdcan1, &sFilterConfig) != HAL_OK)
		{
			  Error_Handler();
		}


		if(HAL_FDCAN_ConfigGlobalFilter(&hfdcan1, FDCAN_REJECT, FDCAN_REJECT, FDCAN_REJECT_REMOTE, FDCAN_REJECT_REMOTE) != HAL_OK)
		{
			  Error_Handler();
		}
	}

	// Deshabilita  filtres //
	else
	{

//		usb_print( "Deshabilita  filtres");

		FDCAN_FilterTypeDef sFilterConfig;

		for(int i = 0; i < 2; i++)
		{
			sFilterConfig.IdType = FDCAN_STANDARD_ID;
			sFilterConfig.FilterIndex = i;
			sFilterConfig.FilterType = FDCAN_FILTER_DUAL;
			sFilterConfig.FilterConfig = FDCAN_FILTER_DISABLE;
			sFilterConfig.FilterID1 = 0x00;
			sFilterConfig.FilterID2 = 0x00;

			if(HAL_FDCAN_ConfigFilter(&hfdcan1, &sFilterConfig) != HAL_OK)
			{
				  Error_Handler();
			}

			sFilterConfig.IdType = FDCAN_EXTENDED_ID;
			sFilterConfig.FilterIndex = i;
			sFilterConfig.FilterType = FDCAN_FILTER_DUAL;
			sFilterConfig.FilterConfig = FDCAN_FILTER_DISABLE;
			sFilterConfig.FilterID1 = 0x00;
			sFilterConfig.FilterID2 = 0x00;

			if(HAL_FDCAN_ConfigFilter(&hfdcan1, &sFilterConfig) != HAL_OK)
			{
				  Error_Handler();
			}
		}
		if(HAL_FDCAN_ConfigGlobalFilter(&hfdcan1, FDCAN_ACCEPT_IN_RX_FIFO0, FDCAN_ACCEPT_IN_RX_FIFO0, FDCAN_ACCEPT_IN_RX_FIFO0, FDCAN_ACCEPT_IN_RX_FIFO0) != HAL_OK)
		{
			  Error_Handler();
		}
	}

	// Inicia CAN bus //
	if (HAL_FDCAN_Start(&hfdcan1) != HAL_OK)
	{
		Error_Handler();
	}
}


//////////////////////////////////////////////////////////////////////////
// SPI TX Interrupt
//////////////////////////////////////////////////////////////////////////

void HAL_SPI_TxCpltCallback(SPI_HandleTypeDef *hspi)
{
}


//////////////////////////////////////////////////////////////////////////
// GPIO External Interrupt for touchscreen
//////////////////////////////////////////////////////////////////////////

void HAL_GPIO_EXTI_Callback(uint16_t GPIO_Pin)
{
	if(GPIO_Pin == TP_IRQ_Pin )
	{
		// Touch external interrupt //
		touchFlg = true;
	}
}


/* USER CODE END 0 */

/**
  * @brief  The application entry point.
  * @retval int
  */
int main(void)
{

  /* MCU Configuration--------------------------------------------------------*/

  /* Reset of all peripherals, Initializes the Flash interface and the Systick. */
  HAL_Init();

  /* Configure the system clock */
  SystemClock_Config();

  /* Initialize all configured peripherals */
  MX_GPIO_Init();
  MX_DMA_Init();
  MX_SPI1_Init();
  MX_USART1_UART_Init();
  MX_USB_Device_Init();
  MX_ADC1_Init();
  MX_FDCAN1_Init();
  MX_I2C4_Init();
  /* USER CODE BEGIN 2 */

//  HAL_ADCEx_Calibration_Start(&hadc1);

  // lvgl init //
  lv_init();

  // Display init //
  tft_init();
  tft_setRotation(1);
  tp_init();

  // show init logo //
  init_logo();

//  // log lvgl debug //
//  lv_log_register_print_cb(my_log_cb);

  usb_print("\r\n ******************** Control Xic ******************** \n\r");
//  sprintf(strCdc, "\n\r %d - %d - %d", millis, tp_x, tp_y);
//  usb_print(strCdc);
//	HAL_Delay(500);


  /* USER CODE END 2 */

  /* Infinite loop */
  /* USER CODE BEGIN WHILE */
  while(1)
  {
	  //////////////////////////////////////////////////////////////////////////
	  // LVG internal tasks //
	  //////////////////////////////////////////////////////////////////////////
	  lv_timer_handler();


	  //////////////////////////////////////////////////////////////////////////
	  // Work Flow, Display print, timeouts, ... //
	  //////////////////////////////////////////////////////////////////////////
	  main_task();




    /* USER CODE END WHILE */

    /* USER CODE BEGIN 3 */
  }
  /* USER CODE END 3 */
}

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
