controlXic/Pocket_CAN/00_FIRMWARE/STM32G474ws/canfd_tool_g474ret6/canfd_tool_g474ret6.ioc

Mcu.UserName=STM32G474RETx
PA10.Signal=USART1_RX
PA11.Signal=USB_DM
PA12.Signal=USB_DP
PA13.Signal=SYS_JTMS-SWDIO
PA14.Signal=SYS_JTCK-SWCLK
PA3.GPIO_Label=SD_CS
PA3.Signal=GPIO_Output
PA4.GPIO_Label=SD_DET
PA4.Signal=GPIO_Output
PA5.Signal=SPI1_SCK
PA6.Signal=SPI1_MISO
PA7.Signal=SPI1_MOSI
PA9.Signal=USART1_TX
PB0.GPIO_Label=TFT_RST
PB0.Signal=GPIO_Output
PB1.GPIO_Label=TFT_DC
PB1.Signal=GPIO_Output
PB11.GPIO_Label=BTN_CFG
PB11.Signal=GPIO_Input
PB2.GPIO_Label=TP_IRQ
PB2.Signal=GPXTI2
PB3.Signal=SYS_JTDO-SWO
PB5.Signal=FDCAN2_RX
PB6.Signal=FDCAN2_TX
PB8-BOOT0.Signal=FDCAN1_RX
PB9.Signal=FDCAN1_TX
PC0.GPIO_Label=ADC_BAT
PC0.Signal=ADC1_IN6
PC4.GPIO_Label=TP_BL
PC4.Signal=GPIO_Output
PC5.GPIO_Label=TFT_CS
PC5.Signal=GPIO_Output
PC6.Signal=I2C4_SCL
PC7.Signal=I2C4_SDA
PC8.Signal=I2C3_SCL
PC9.Signal=I2C3_SDA
PF0-OSC_IN.Signal=RCC_OSC_IN
PF1-OSC_OUT.Signal=RCC_OSC_OUT
PG10-NRST.GPIO_Label=NRST
PG10-NRST.Signal=EVENTOUT
