controlXic/Pocket_CAN/00_FIRMWARE/STM32G474ws/canfd_tool_g474ret6/Core/Inc/main.h

#define NRST_Pin GPIO_PIN_10
#define NRST_GPIO_Port GPIOG
#define ADC_BAT_Pin GPIO_PIN_0
#define ADC_BAT_GPIO_Port GPIOC
#define SD_CS_Pin GPIO_PIN_3
#define SD_CS_GPIO_Port GPIOA
#define SD_DET_Pin GPIO_PIN_4
#define SD_DET_GPIO_Port GPIOA
#define TP_BL_Pin GPIO_PIN_4
#define TP_BL_GPIO_Port GPIOC
#define TFT_CS_Pin GPIO_PIN_5
#define TFT_CS_GPIO_Port GPIOC
#define TFT_RST_Pin GPIO_PIN_0
#define TFT_RST_GPIO_Port GPIOB
#define TFT_DC_Pin GPIO_PIN_1
#define TFT_DC_GPIO_Port GPIOB
#define TP_IRQ_Pin GPIO_PIN_2
#define TP_IRQ_GPIO_Port GPIOB
#define TP_IRQ_EXTI_IRQn EXTI2_IRQn
#define BTN_CFG_Pin GPIO_PIN_11
#define BTN_CFG_GPIO_Port GPIOB
