controlXic/Pocket_CAN/00_FIRMWARE/STM32G474ws/canfd_tool_g474ret6/Core/Inc/main_system.h

/*
 * main_system.h
 *
 *  Created on: Jul 4, 2025
 *      Author: Pep
 */

#ifndef INC_MAIN_SYSTEM_H_
#define INC_MAIN_SYSTEM_H_


void main_task();
void filters_window();

#endif /* INC_MAIN_SYSTEM_H_ */
