controlXic/Pocket_CAN/00_FIRMWARE/STM32G474ws/canfd_tool_g474ret6/Core/Inc/main_window.h

/*
 * main_window.h
 *
 *  Created on: Feb 8, 2025
 *      Author: Pep
 */

#ifndef INC_MAIN_WINDOW_H_
#define INC_MAIN_WINDOW_H_

void init_logo();
void init_window();

void init_config();

//void draw_canRxTable_cb(lv_event_t * e);
//void draw_canTxTable_cb(lv_event_t * e);
//void click_canTxTable_cb(lv_event_t * e);
//void ta_event_cb(lv_event_t * e);
//void ta_event_cb(lv_event_t * e);





#endif /* INC_MAIN_WINDOW_H_ */
