controlXic/Pocket_CAN/00_FIRMWARE/STM32G474ws/canfd_tool_g474ret6/Core/Inc/usart_terminal.h

/*
 * usart_terminal.h
 *
 *  Created on: Jul 5, 2025
 *      Author: Pep
 */

#ifndef INC_USART_TERMINAL_H_
#define INC_USART_TERMINAL_H_


void init_uartDebug();
void print_rx_usart();


#endif /* INC_USART_TERMINAL_H_ */
