controlXic/Pocket_CAN/(notices)

Notices in the files:
00_FIRMWARE/STM32G474ws/canfd_tool_g474ret6/Core/Src/main.c:
Copyright (c) 2025 STMicroelectronics.
All rights reserved.
This software is licensed under terms that can be found in the LICENSE file
